marangisto/SteinerVCF/render-board.png

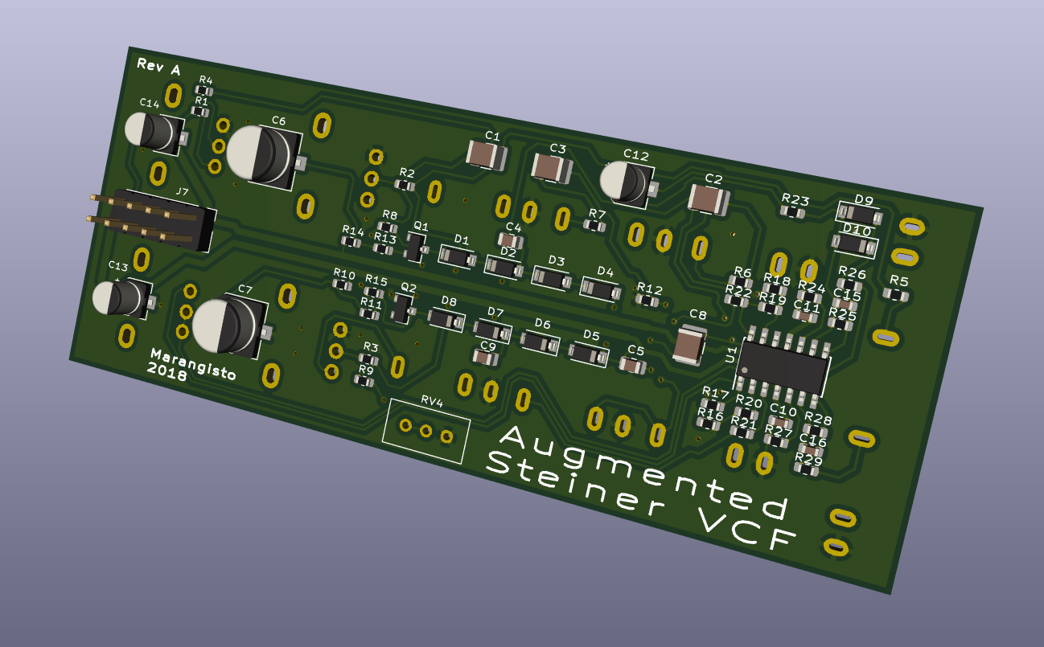
render-board.png
