marangisto/SteinerVCF/raytrace-front.png

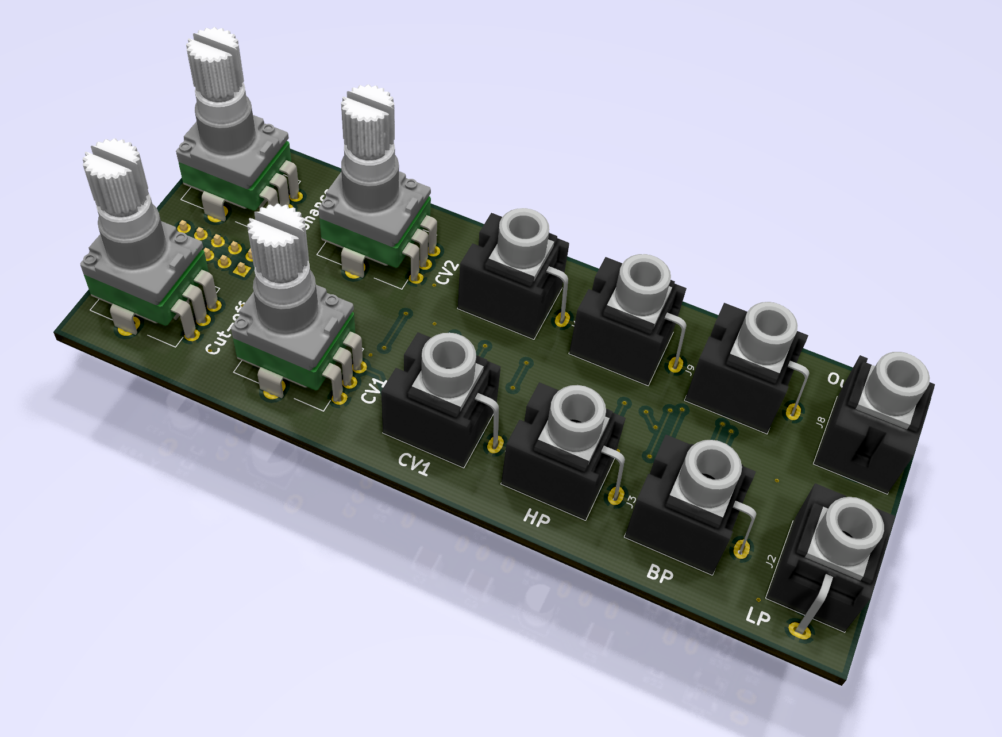
raytrace-front.png
