marangisto/SteinerVCF/png/IMG_0112.jpg

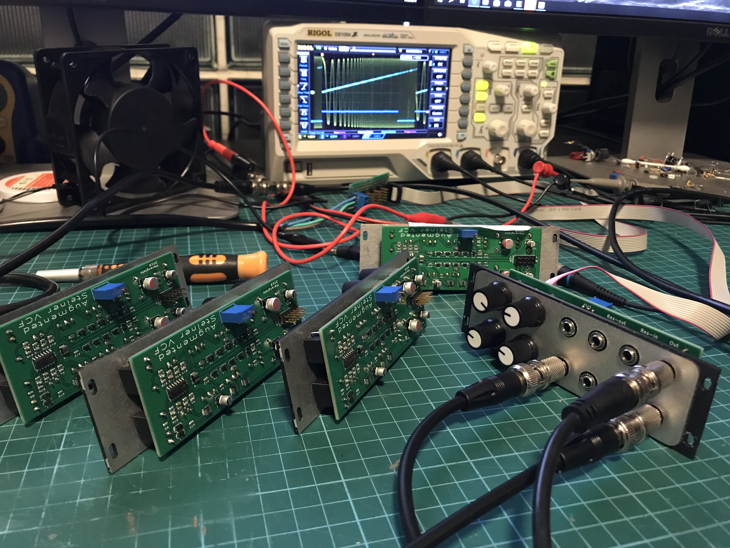
png/IMG_0112.jpg
