marangisto/SteinerVCF/raytrace-back.png

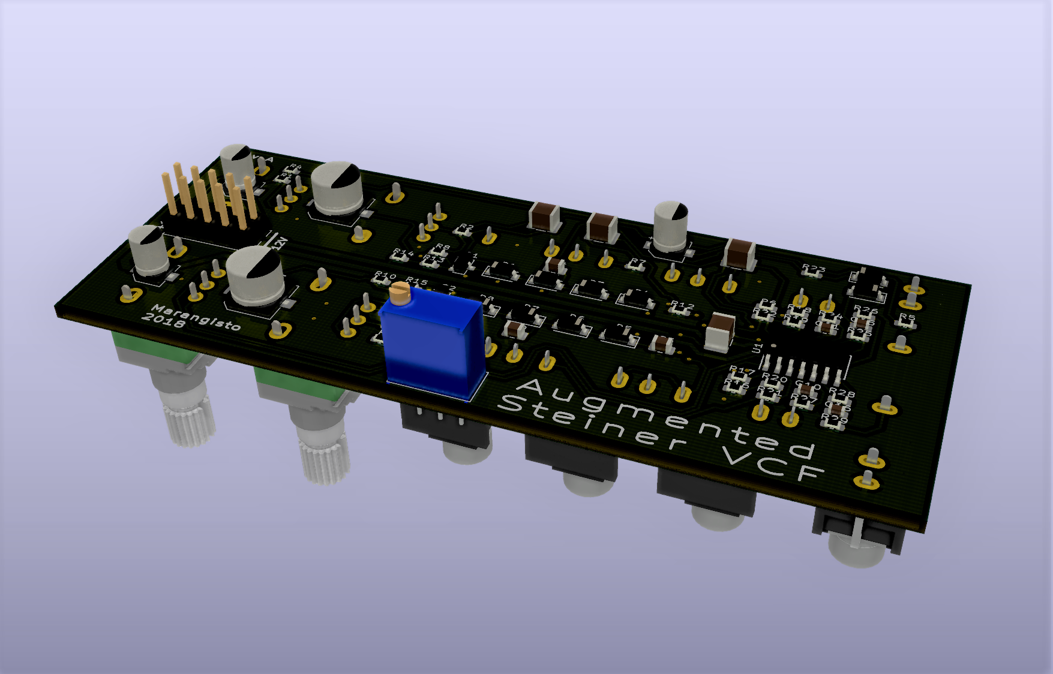
raytrace-back.png
