marangisto/SteinerVCF/render-panel2.png

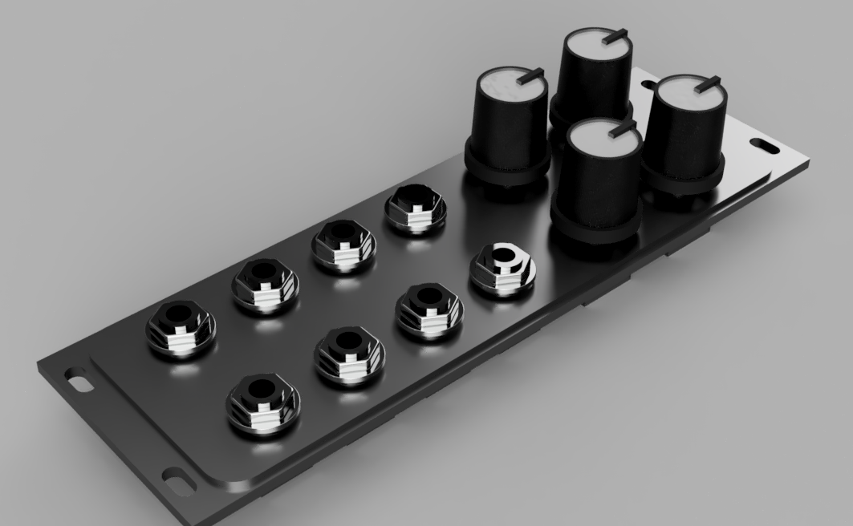
render-panel2.png
