marangisto/SteinerVCF/render-panel.png

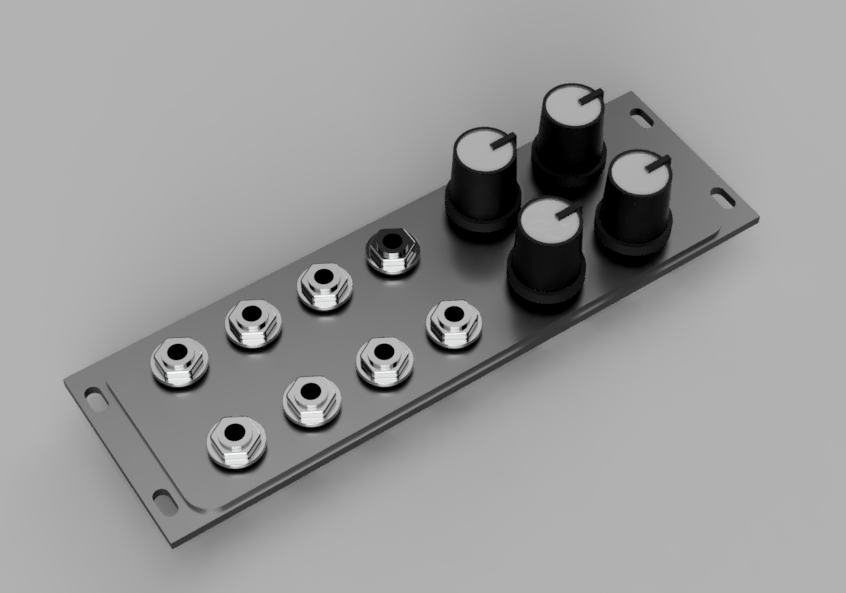
render-panel.png
