marangisto/SteinerVCF/render-pcb.png

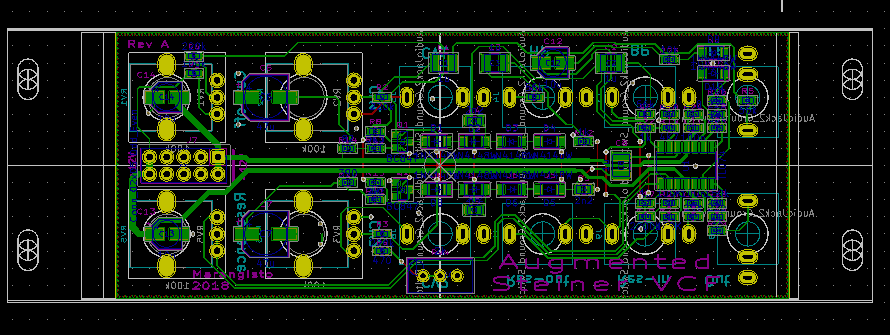
render-pcb.png
