marangisto/SteinerVCF/Response.png

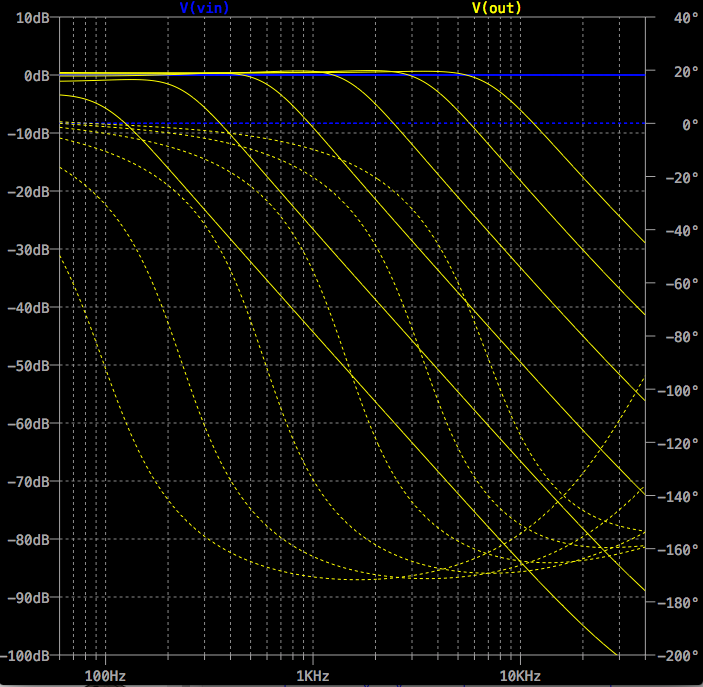
Response.png
