marangisto/SteinerVCF/EdgeCuts.dxf

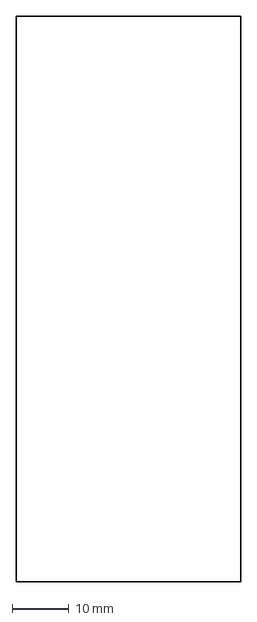
[picture p9: CAD file, 2018-11-03]
EdgeCuts.dxf
39.6 x 100.0 mm
