marangisto/SteinerVCF/Board.dxf

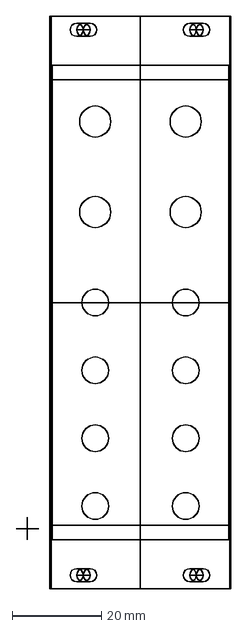
[picture p10: CAD file, 2018-11-03]
Board.dxf
48.3 x 128.5 mm
