marangisto/SteinerVCF/SteinerVCF.kicad_pcb

## KiCad design SteinerVCF.kicad_pcb (2018-11-11)

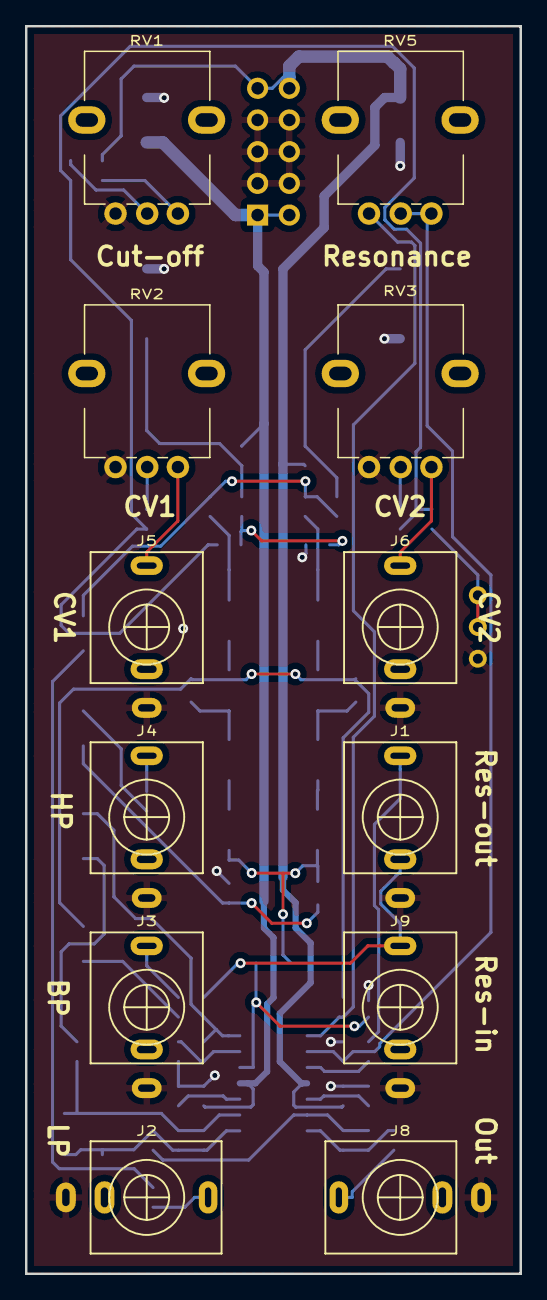
[picture p11: board SteinerVCF.kicad_pcb from above]

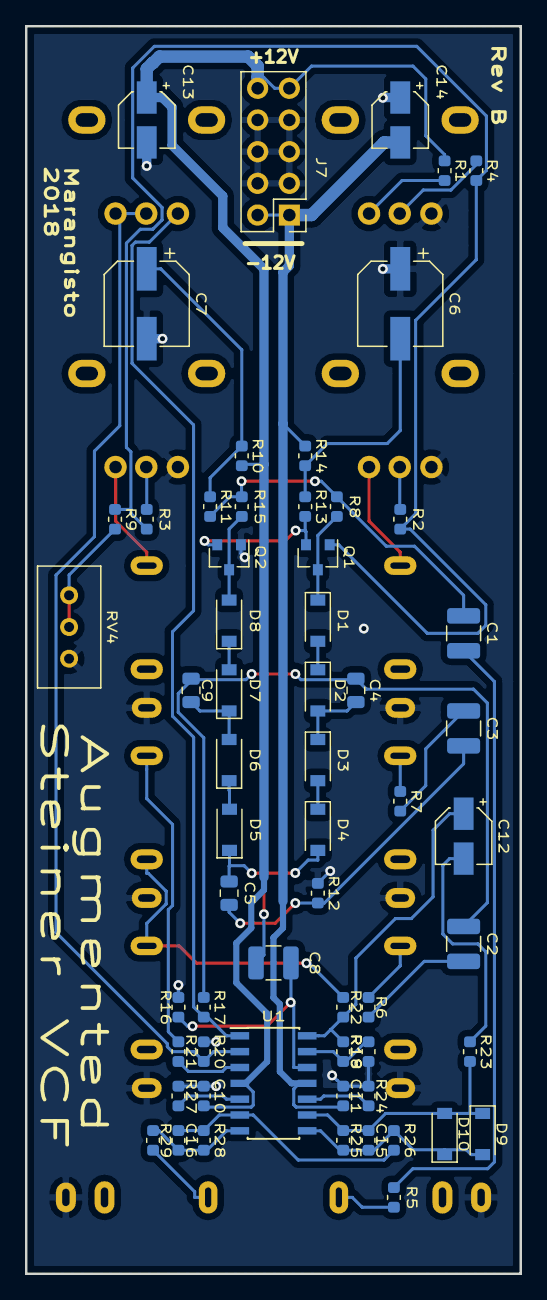
[picture p12: board SteinerVCF.kicad_pcb from below]

Board: 2 copper layers, 39.6 x 100.0 mm, 72 parts (60 on the bottom side), 48 nets.

Parts:
C1, C2, C3, C8: 1u; C_1210_3225Metric
C4, C5, C9: 2n2; C_0805_2012Metric
C6, C7: 47u; CP_Elec_6.3x5.4
C10, C11: 100n; C_0603_1608Metric
C12, C13, C14: 10u; CP_Elec_4x5.8
C15, C16: 22p; C_0603_1608Metric
D1, D2, D3, D4, D5, D6, D7, D8, D9, D10: 1N4148W; D_SOD-123
J1, J2, J3, J4, J5, J6, J8, J9: AudioJack2_Ground_Switch; PJ398SM
J7: Conn_02x05_Odd_Even; PinHeader_2x05_P2.54mm_Vertical
Q1, Q2: BC847; SOT-23
R1: 100k; R_0603_1608Metric
R2, R3, R4: 220k; R_0603_1608Metric
R5, R6, R7: 56k; R_0603_1608Metric
R8, R15: 2k2; R_0603_1608Metric
R9: 470; R_0603_1608Metric
R10: 390; R_0603_1608Metric
R11, R12, R17, R22, R29: 1k; R_0603_1608Metric
R13: 3K3; R_0603_1608Metric
R14: 82; R_0603_1608Metric
R16: 2200k; R_0603_1608Metric
R18: 22k; R_0603_1608Metric
R19: 4K7; R_0603_1608Metric
R20, R21: 100K; R_0603_1608Metric
R23, R26, R27: 10k; R_0603_1608Metric
R24: 6k8; R_0603_1608Metric
R25: 33k; R_0603_1608Metric
R28: 150k; R_0603_1608Metric
RV1, RV2, RV3, RV5: 100k; AlpsRK09K
RV4: 2k; Bourns3296WV
U1: TL074; SOIC-14_3.9x8.7mm_P1.27mm

Connections:
+12V: C10.1, C13.1, J7.9, J7.10, R1.2, R10.1, U1.4
-12V: C11.2, C14.2, J7.1, J7.2, R14.2, U1.11
/BP: J3.T, R6.2
/CV1: J5.T, RV2.1
/CV2: J6.T, RV3.1
/CutOff: R4.2, RV1.2
/HP: J4.T, R7.2
/LP: J2.T, R5.2
/Resonance: R20.1, RV5.1, RV5.2, U1.2
GND: C6.1, C7.2, C10.2, C11.1, C13.2, C14.1, J1.S, J2.S, J3.S, J4.S, J5.S, J6.S, J7.3, J7.4, J7.5, J7.6, J7.7, J7.8, J8.S, J9.S, Q2.1, R12.2, R16.2, R18.2, R20.2, R24.2, R27.2, RV1.3, RV2.3, RV3.3, RV4.3
LoopIn: J1.T, R21.1
LoopOut: J1.TN, J9.T, R22.1
unnamed: C1.1, R8.1, R11.1, R15.1
unnamed: C1.2, R5.1
unnamed: C2.1, C4.2, C9.2, R17.2
unnamed: C2.2, R6.1
unnamed: C3.1, C5.2, R12.1
unnamed: C3.2, R7.1
unnamed: C4.1, D2.2, D3.1
unnamed: C5.1, C8.2, D4.2, D5.1
unnamed: C6.2, R13.2, R14.1
unnamed: C7.1, R10.2, R11.2
unnamed: C8.1, R16.1, U1.12
unnamed: C9.1, D6.2, D7.1
unnamed: C12.1, R19.1, R22.2, U1.14
unnamed: C12.2, R23.2
unnamed: C15.1, D9.2, D10.1, R25.1, R26.2, U1.8
unnamed: C15.2, D9.1, D10.2, R23.1, R25.2, U1.9
unnamed: C16.1, R28.1, R29.2, U1.7
unnamed: C16.2, R26.1, R28.2, U1.6
unnamed: D1.1, Q1.3, R8.2
unnamed: D1.2, D2.1
unnamed: D3.2, D4.1
unnamed: D5.2, D6.1
unnamed: D7.2, D8.1
unnamed: D8.2, Q2.3, R15.2
unnamed: J8.T, R29.1
unnamed: Q1.1, R2.2, R3.2, R4.1, R9.1
unnamed: Q1.2, Q2.2, R13.1
unnamed: R1.1, RV1.1
unnamed: R2.1, RV2.2
unnamed: R3.1, RV3.2
unnamed: R9.2, RV4.1, RV4.2
unnamed: R17.1, RV5.3, U1.1
unnamed: R18.1, R19.2, U1.13
unnamed: R21.2, U1.3
unnamed: R24.1, U1.10
unnamed: R27.1, U1.5
