marangisto/SteinerVCF/(commit log)

2018-10-13 Initial circuit (based on Ken Stone's design).
    [SteinerVCF.kicad_pcb, SteinerVCF.sch]
2018-10-25 Integrated changes from yusynth's schematic.
    [SteinerVCF.sch]
2018-10-25 Added footprints.
    [SteinerVCF.kicad_pcb, SteinerVCF.sch]
2018-10-28 Early placement.
    [SteinerVCF.kicad_pcb, SteinerVCF.sch]
2018-11-02 Lots of spicing.
    [SteinerVCF.sch]
2018-11-03 Two-stage output.
2018-11-03 12V version and output low-pass.
2018-11-03 Moved and balanced clipping circuit.
2018-11-03 Added board layout drawing.
    [Board.dxf]
2018-11-03 Added edge-cuts.
    [EdgeCuts.dxf, SteinerVCF.kicad_pcb]
2018-11-03 Redesigned schematic based on spice simulation.
    [SteinerVCF.sch]
2018-11-03 Swap input resistors and caps.
    [SteinerVCF.sch]
2018-11-03 Initial component placement.
    [SteinerVCF.kicad_pcb]
2018-11-03 More placement.
    [SteinerVCF.kicad_pcb, SteinerVCF.sch]
2018-11-04 Full-board placement complete.
    [SteinerVCF.kicad_pcb]
2018-11-04 Completed signal routing.
    [SteinerVCF.kicad_pcb]
2018-11-04 Ground pours and stiching.
    [SteinerVCF.kicad_pcb]
2018-11-04 Better placement of large caps.
    [SteinerVCF.kicad_pcb]
2018-11-04 Moved some caps away from the edge.
    [SteinerVCF.kicad_pcb]
2018-11-04 Silkscreen orientation.
    [SteinerVCF.kicad_pcb]
2018-11-04 Silkscreen branding.
    [SteinerVCF.kicad_pcb]
2018-11-04 Added a board image.
2018-11-04 Added BOM.
    [SteinerVCF.csv]
2018-11-04 Added gerbers.
    [SteinerVCF-B.Cu.gbr, SteinerVCF-B.Mask.gbr, SteinerVCF-B.Paste.gbr, SteinerVCF-B.SilkS.gbr, SteinerVCF-Edge.Cuts.gbr, SteinerVCF-F.Cu.gbr, SteinerVCF-F.Mask.gbr, SteinerVCF-F.SilkS.gbr]
2018-11-04 Updated silk-screein with power designators.
    [SteinerVCF-B.Cu.gbr, SteinerVCF-B.Mask.gbr, SteinerVCF-B.Paste.gbr, SteinerVCF-B.SilkS.gbr, SteinerVCF-Edge.Cuts.gbr, SteinerVCF-F.Cu.gbr, SteinerVCF-F.Mask.gbr, SteinerVCF-F.SilkS.gbr]
2018-11-04 Added pcb image.
2018-11-06 Added 3-d model for RK09 potentiometer.
    [SteinerVCF.kicad_pcb]
2018-11-06 Added 3-model for PJ398SM.
    [SteinerVCF.kicad_pcb]
2018-11-06 Added bourns trimmer 3-d model.
    [SteinerVCF.kicad_pcb, SteinerVCF.sch]
2018-11-06 Added ray-trace renderings.
2018-11-06 Modeled threads.
2018-11-11 Freerouted signals.
    [SteinerVCF.kicad_pcb]
2019-03-14 Added png files for calibration procedure.
